abdoboua/PLL_Applications/(list of files, drawings)

Other design files:
PLL_Applications_Project.pdsprj
