abdoboua/PLL_Applications/20181029_120217.jpg

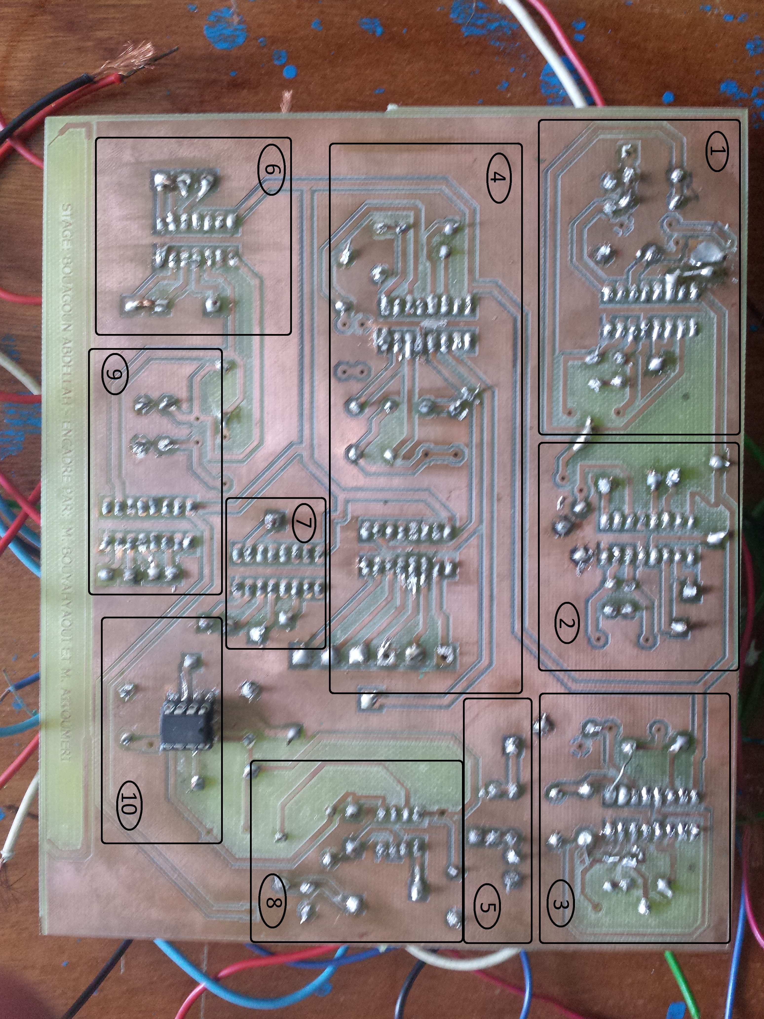
20181029_120217.jpg
